Jockkoo/Ohmsprint-2026-4Digitalca/project_files/README.md

# Ohmsprint-2026-4Digitalca
Ohmsprint hackaton 2026. KiCad
