Jockkoo/Ohmsprint-2026-4Digitalca/project_files/Ohmsprint.kicad_pcb

## KiCad design project_files/Ohmsprint.kicad_pcb (2026-04-16)

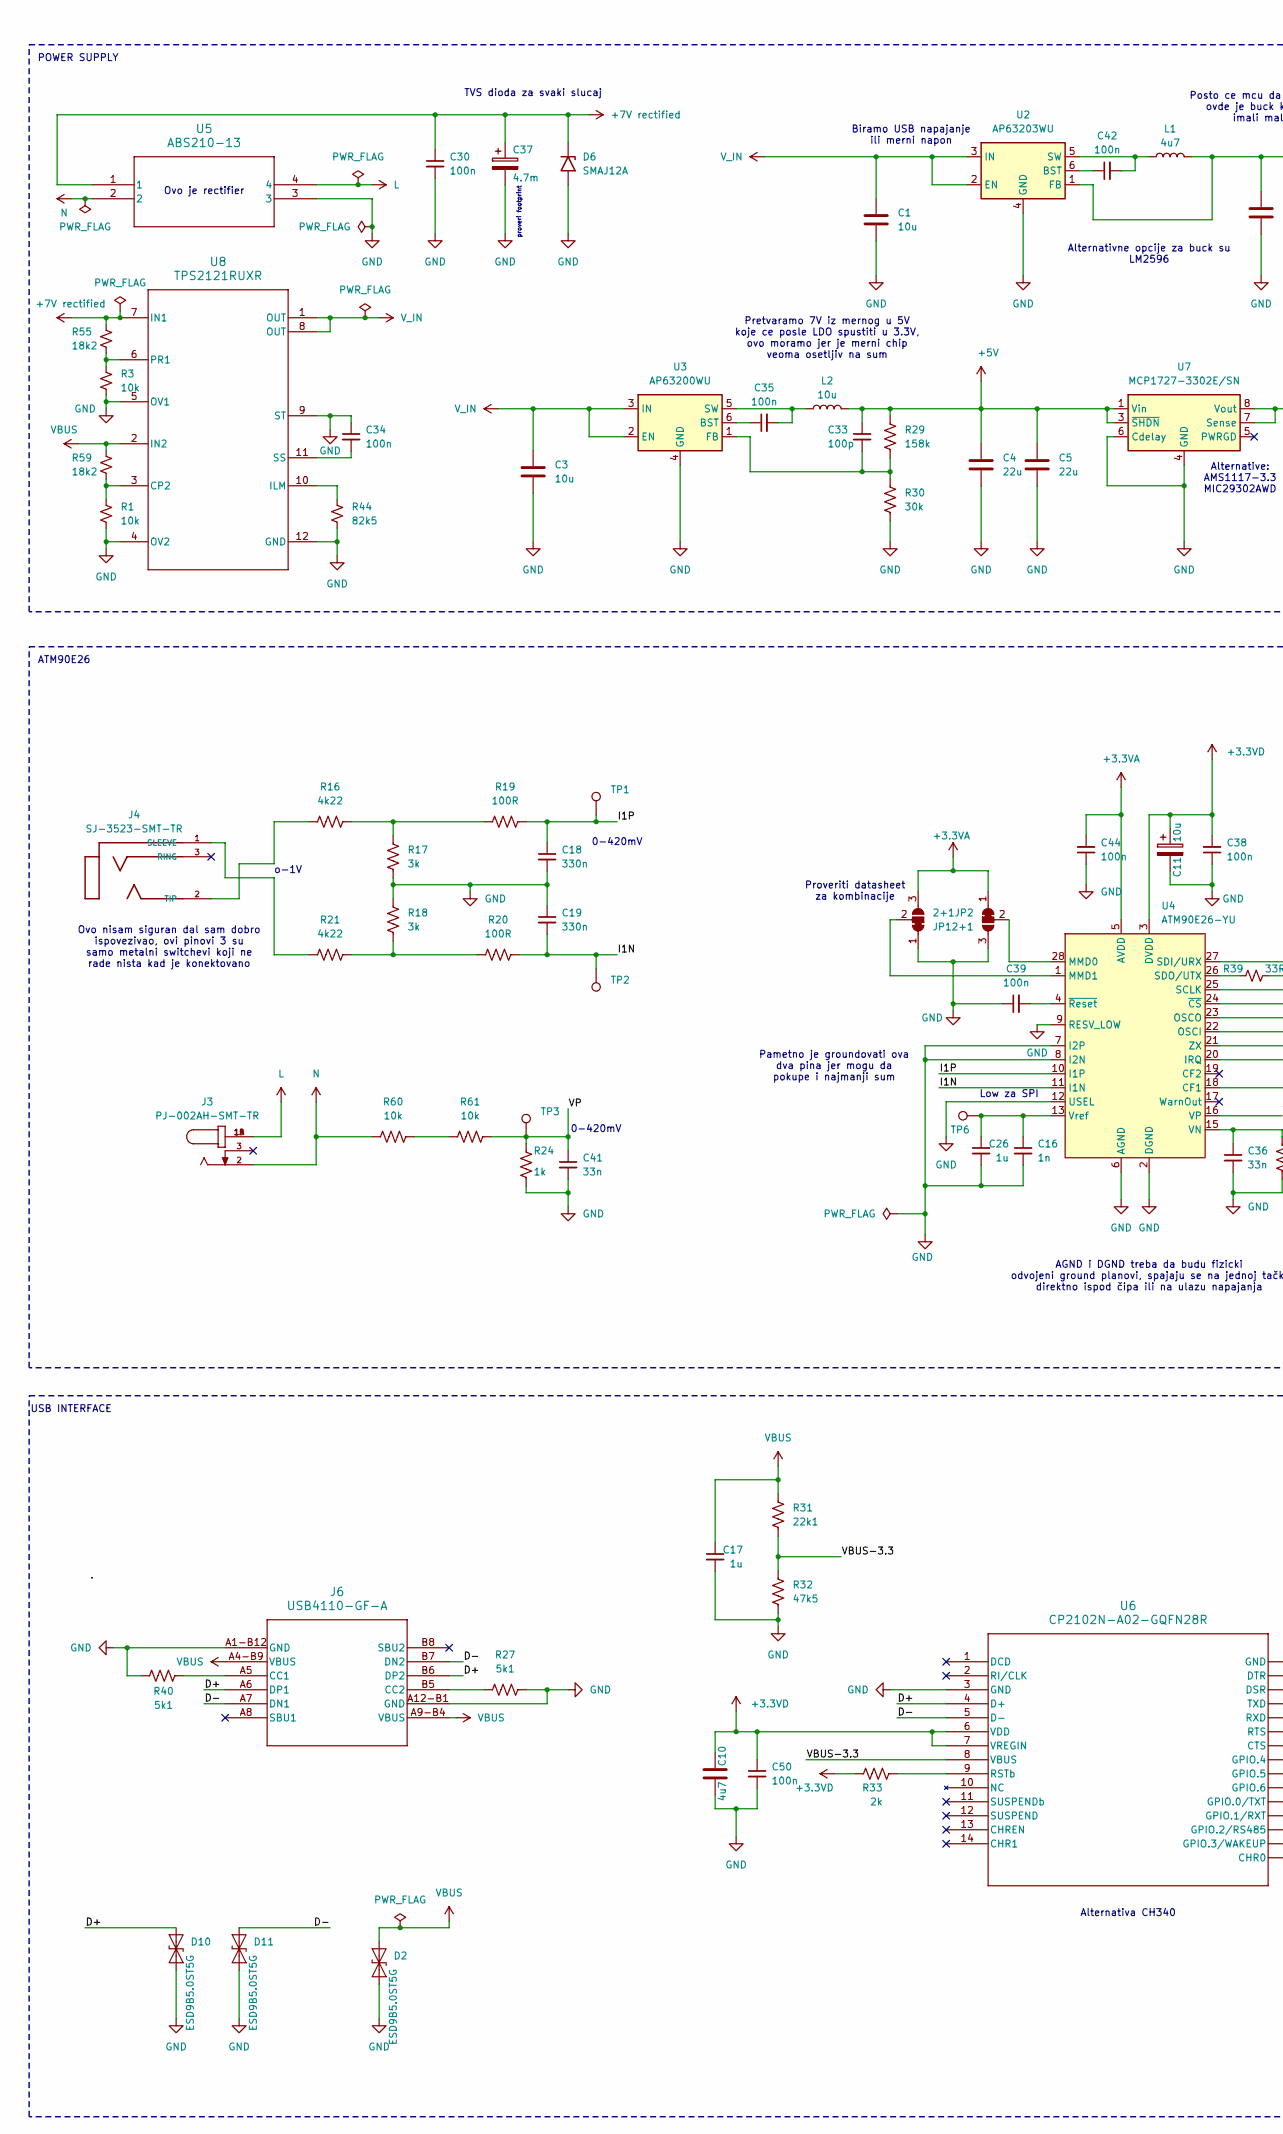
[picture p1: schematic Ohmsprint.kicad_sch, part in row 1, column 1]

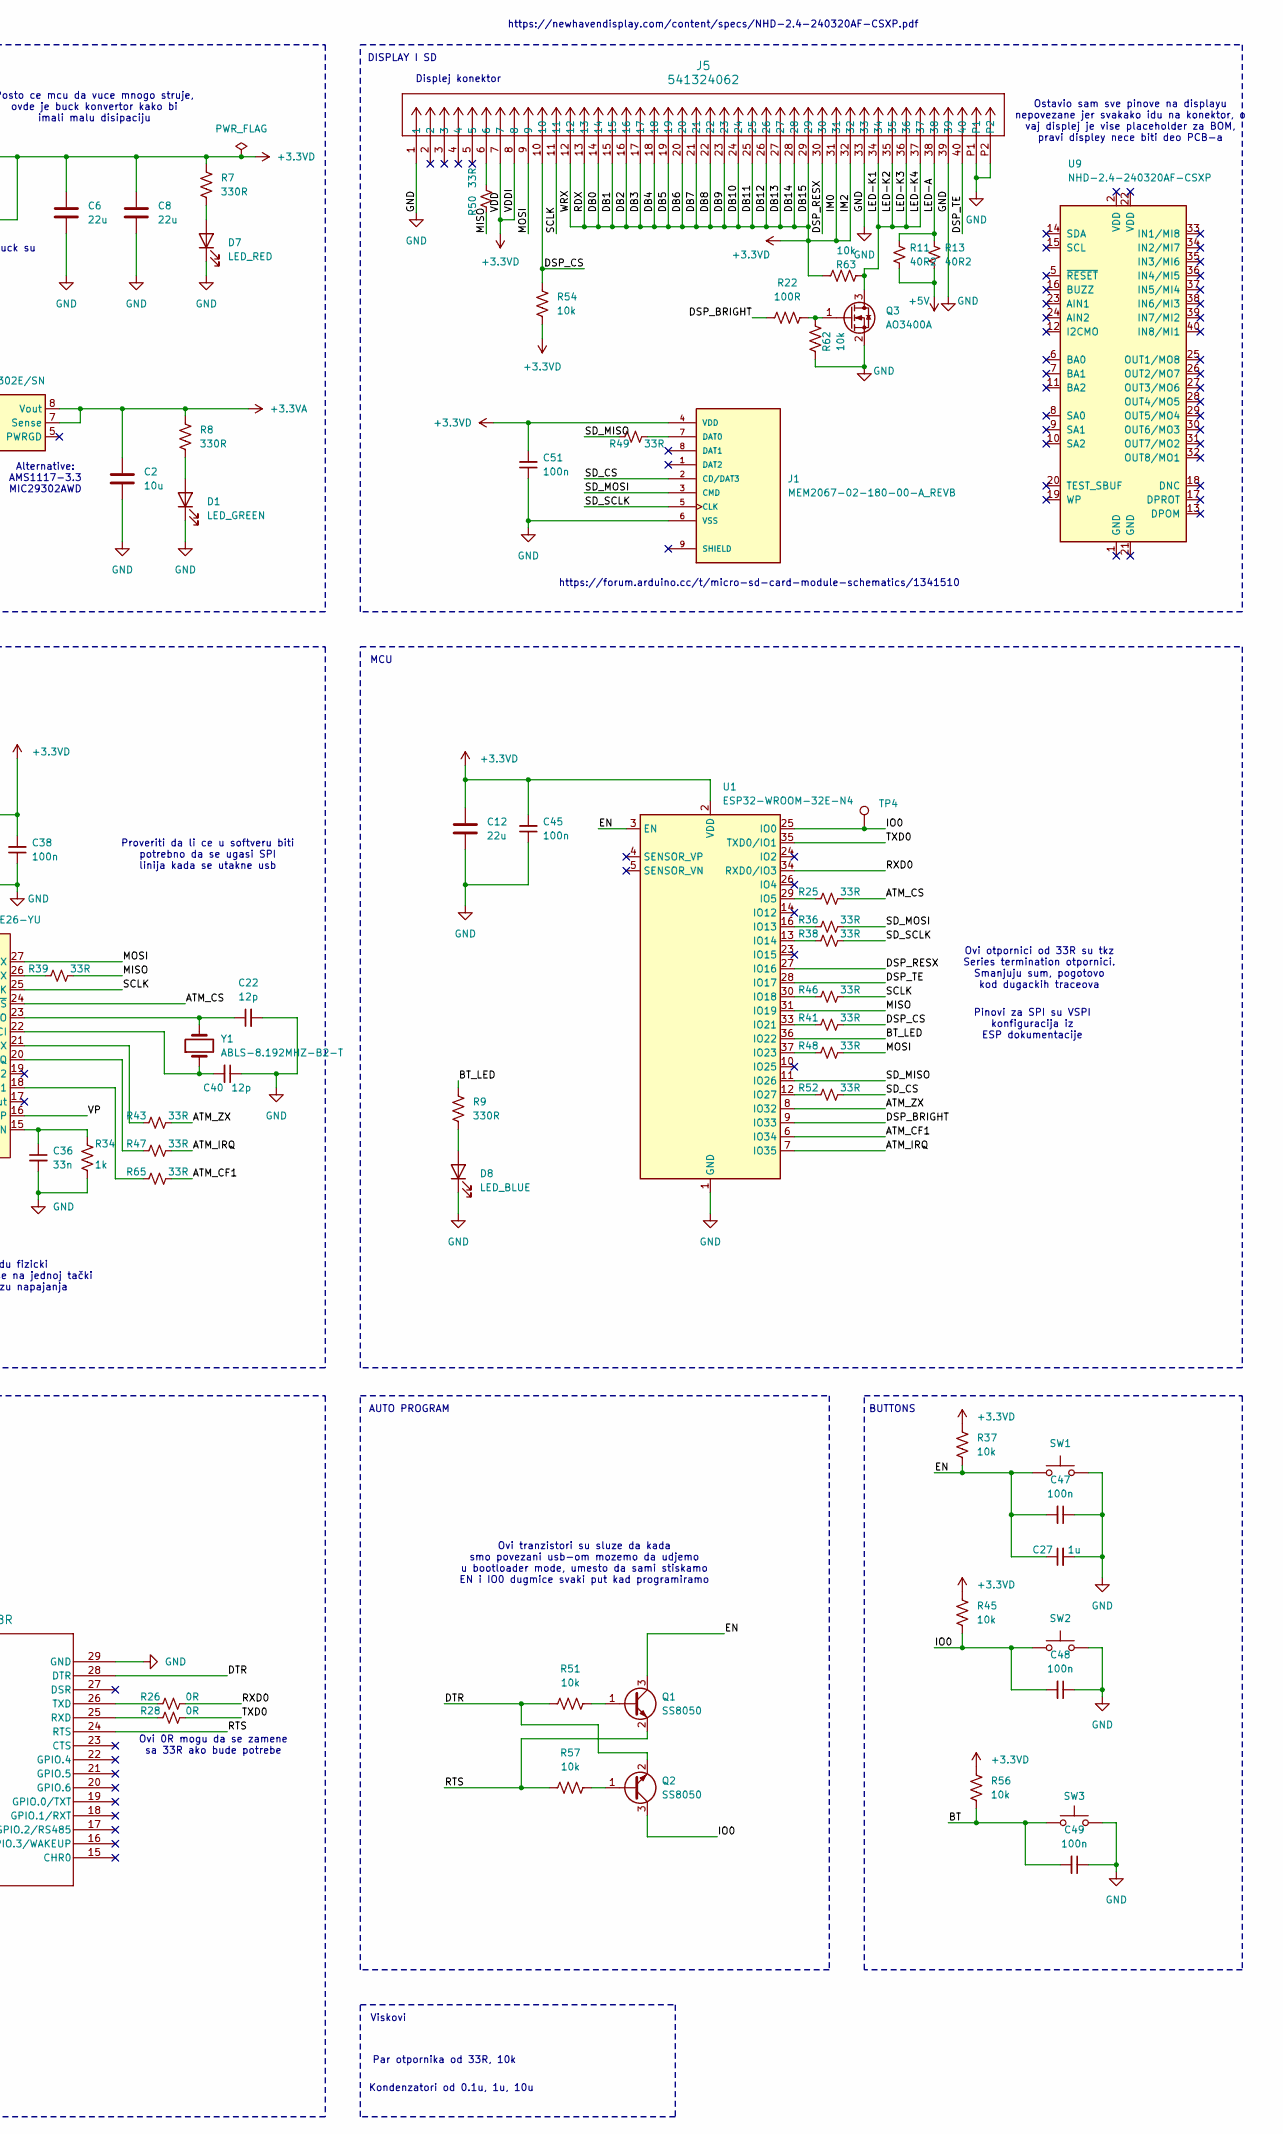
[picture p2: schematic Ohmsprint.kicad_sch, part in row 1, column 2]

Parts:
C1, C2, C3: 10u; C_0805_2012Metric; MPN CL21B106KOQNNNE; DigiKey Part Number 1276-2872-1-ND
C4, C5, C6, C8, C12: 22u; C_1210_3225Metric; MPN CL32B226MOJNNNE; DigiKey Part Number 1276-3395-1-ND
C10: 4u7; C_0603_1608Metric; MPN GRM188R61E475KE11D; DigiKey Part Number 490-7203-1-ND
C11: 10u; CP_Elec_4x5.7; MPN EDH106M016A9BAA; DigiKey Part Number 399-17336-1-ND
C16: 1n; C_0603_1608Metric; MPN C0603C102K5RACTU; DigiKey Part Number 399-C0603C102K5RACTUCT-ND
C17, C26, C27: 1u; C_0603_1608Metric; MPN C0603C105K4RACTU; DigiKey Part Number 399-C0603C105K4RACTUCT-ND
C18, C19: 330n; C_0603_1608Metric; MPN C1608X7R1H334K080AC; DigiKey Part Number 445-5950-1-ND
C22, C40: 12p; C_0603_1608Metric; MPN KGQ15ACG2D120GT; DigiKey Part Number 478-KGQ15ACG2D120GTCT-ND
C30, C34, C35, C38, C39, C42, C44, C45, C47, C48, C49, C50, C51: 100n; C_0603_1608Metric; MPN C0603C104K3RACTU; DigiKey Part Number 399-C0603C104K3RACTUCT-ND
C33: 100p; C_0603_1608Metric; MPN GRM1885C1H101JA01D; DigiKey Part Number 490-1427-1-ND
C36, C41: 33n; C_0603_1608Metric; MPN C0603C333K4RACTU; DigiKey Part Number 399-C0603C333K4RACTUCT-ND
C37: 4.7m; CP_Elec_16x17.5; MPN EMHS160ARA472MLN0S; DigiKey Part Number 565-EMHS160ARA472MLN0SCT-ND
D1: LED_GREEN; LED_0805_2012Metric; MPN LTST-C171KGKT; DigiKey Part Number 160-1426-1-ND
D2, D10, D11: ESD9B5.0ST5G; D_SOD-923; MPN ESD9B5.0ST5G; DigiKey Part Number ESD9B5.0ST5GOSCT-ND
D6: SMAJ12A; D_SMA; MPN SMAJ12A; DigiKey Part Number SMAJ12ALFCT-ND
D7: LED_RED; LED_0805_2012Metric; MPN LTST-C171KRKT; DigiKey Part Number 160-1427-1-ND
D8: LED_BLUE; LED_0805_2012Metric; MPN LTST-C171TBKT; DigiKey Part Number 160-1645-1-ND
J1: MEM2067-02-180-00-A_REVB; GCT_MEM2067-02-180-00-A_REVB; MPN MEM2067-02-180-00-A
J3: PJ-002AH-SMT-TR; CUI_PJ-002AH-SMT-TR; MPN PJ-002AH-SMT-TR; DigiKey Part Number CP-002AHPJCT-ND
J4: SJ-3523-SMT-TR; CUI_SJ-3523-SMT-TR; MPN SJ-3523-SMT-TR; DigiKey Part Number CP-3523SJCT-ND
J5: 541324062; CON_541324062_MOL; MPN 0541324062; DigiKey Part Number WM3436CT-ND
J6: USB4110-GF-A; USB4110-GF-A_GCT; MPN USB4110-GF-A
JP1, JP2: 2+1; SolderJumper-3_P1.3mm_Bridged12_RoundedPad1.0x1.5mm
L1: 4u7; L_1210_3225Metric; MPN 1277AS-H-4R7M=P2; DigiKey Part Number 490-10594-1-ND
L2: 10u; L_1210_3225Metric; MPN AOTA-C322512Q100MT; DigiKey Part Number 535-AOTA-C322512Q100MTCT-ND
Q1, Q2: SS8050; SOT-23; MPN SS8050; DigiKey Part Number 5399-SS8050CT-ND
Q3: AO3400A; SOT-23; MPN AO3400A; DigiKey Part Number 4518-AO3400ACT-ND
R1, R3, R37, R45, R51, R54, R56, R57, R60, R61, R62, R63: 10k; R_0603_1608Metric; MPN RC0603FR-0710KL; DigiKey Part Number 311-10.0KHRCT-ND
R7, R8, R9: 330R; R_0603_1608Metric; MPN RC0603FR-07330RL; DigiKey Part Number 311-330HRCT-ND
R11, R13: 40R2; R_0805_2012Metric; MPN CRCW080540R2FKEA; DigiKey Part Number 541-40.2CCT-ND
R16, R21: 4k22; R_0603_1608Metric; MPN RC0603FR-074K22L; DigiKey Part Number 311-4.22KHRCT-ND
R17, R18: 3k; R_0603_1608Metric; MPN RC0603FR-073KL; DigiKey Part Number 311-3.00KHRCT-ND
R19, R20, R22: 100R; R_0603_1608Metric; MPN RC0603FR-07100RL; DigiKey Part Number 311-100HRCT-ND
R24, R34: 1k; R_0603_1608Metric; MPN RC0603FR-071KL; DigiKey Part Number 311-1.00KHRCT-ND
R25, R36, R38, R39, R41, R43, R46, R47, R48, R49, R50, R52, R65: 33R; R_0603_1608Metric; MPN RC0603FR-0733RL; DigiKey Part Number 13-RC0603FR-0733RLCT-ND
R26, R28: 0R; R_0603_1608Metric; MPN RC0603JR-070RL; DigiKey Part Number 311-0.0GRCT-ND
R27, R40: 5k1; R_0603_1608Metric; MPN RC0603FR-075K1L; DigiKey Part Number 311-5.10KHRCT-ND
R29: 158k; R_0603_1608Metric; MPN RC0603FR-07158KL; DigiKey Part Number 311-158KHRCT-ND
R30: 30k; R_0603_1608Metric; MPN RC0603FR-0730KL; DigiKey Part Number 311-30.0KHRCT-ND
R31: 22k1; R_0603_1608Metric; MPN RC0603FR-0722K1L; DigiKey Part Number 311-22.1KHRCT-ND
R32: 47k5; R_0603_1608Metric; MPN RC0603FR-1047K5L; DigiKey Part Number 13-RC0603FR-1047K5LCT-ND
R33: 2k; R_0603_1608Metric; MPN RC0603FR-072KL; DigiKey Part Number 311-2.00KHRCT-ND
R44: 82k5; R_0805_2012Metric; MPN RMCF0805FT82K5; DigiKey Part Number RMCF0805FT82K5CT-ND
R55, R59: 18k2; R_0603_1608Metric; MPN RC0603FR-0718K2L; DigiKey Part Number 311-18.2KHRCT-ND
SW1, SW2: SW_Push_1_Red; SWITCH_45SK43SMTR92LFS; MPN PTS645SK43SMTR92 LFS; DigiKey Part Number CKN9084CT-ND
SW3: SW_Push_2_Blue; SWITCH_43SMTR92LFS; MPN PTS645SM43SMTR92 LFS; DigiKey Part Number CKN9112CT-ND
TP1, TP2, TP3, TP4, TP6: TestPoint; TestPoint_Pad_D2.0mm
U1: ESP32-WROOM-32E-N4; ESP32-WROOM-32D; MPN ESP32-WROOM-32E-N4; DigiKey Part Number 1965-ESP32-WROOM-32E-N4CT-ND
U2: AP63203WU; TSOT-23-6; MPN AP63203WU-7; DigiKey Part Number AP63203WU-7DICT-ND
U3: AP63200WU; TSOT-23-6; MPN AP63200WU-7; DigiKey Part Number AP63200WU-7DICT-ND
U4: ATM90E26-YU; SSOP-28_5.3x10.2mm_P0.65mm; MPN ATM90E26-YU-R; DigiKey Part Number ATM90E26-YU-RCT-ND
U5: ABS210-13; SON_S210-13_DIO; MPN ABS210-13; DigiKey Part Number ABS210-13DICT-ND
U6: CP2102N-A02-GQFN28R; QFN28_5X5_SIL; MPN CP2102N-A02-GQFN28R; DigiKey Part Number 336-5890-1-ND
U7: MCP1727-3302E/SN; SOIC-8_3.9x4.9mm_P1.27mm; MPN MCP1727T-3302E/SN; DigiKey Part Number MCP1727T-3302E/SNCT-ND
U8: TPS2121RUXR; RUX0012A; MPN TPS2121RUXR; DigiKey Part Number 296-53410-1-ND
U9: NHD-2.4-240320AF-CSXP; EA_eDIPTFT32-XXX; MPN NHD-2.4-240320AF-CSXP; DigiKey Part Number 757-NHD-2.4-240320AF-CSXP-ND
Y1: ABLS-8.192MHZ-B2-T; Crystal_SMD_HC49-SD; MPN ABLS-8.192MHZ-B2-T; DigiKey Part Number 535-9090-1-ND

Connections:
+3.3VA: C2.1, C44.2, JP1.3 (B), JP2.1 (A), R8.1, U4.5 (AVDD), U7.7 (Sense), U7.8 (Vout)
+3.3VD: C6.1, C8.1, C10.1, C11.1, C12.1, C38.2, C45.2, C50.1, C51.2, J1.4 (VDD), J5.7, J5.8, J5.12, J5.13, J5.14, J5.15, J5.16, J5.17, J5.18, J5.19, J5.20, J5.21, J5.22, J5.23, J5.24, J5.25, J5.26, J5.27, J5.28, J5.29, J5.31, J5.32, L1.2, R7.1, R33.1, R37.2, R45.2, R54.1, R56.2, R63.1, U1.2 (VDD), U2.1 (FB), U4.3 (DVDD), U6.6 (VDD), U6.7 (VREGIN); also elsewhere on the board
+5V: C4.1, C5.1, C33.1, L2.2, R11.2, R13.2, R29.1, U7.1 (Vin), U7.2 (Vin), U7.3 (~SHDN)
+7V rectified: C30.1, C37.1, D6.1 (A1), R55.1, U5.1, U8.7 (IN1)
/ATM_CF1: R65.2, U1.6 (IO34)
/ATM_CS: R25.2, U4.24 (~CS)
/ATM_IRQ: R47.2, U1.7 (IO35)
/ATM_ZX: R43.2, U1.8 (IO32)
/BT: C49.2, R56.1, SW3.1
/BT_LED: R9.1, U1.36 (IO22)
/D+: D10.2 (A2), J6.A6 (DP1), J6.B6 (DP2), U6.4 (D+)
/D-: D11.2 (A2), J6.A7 (DN1), J6.B7 (DN2), U6.5 (D-)
/DSP_BRIGHT: R22.1, U1.9 (IO33)
/DSP_CS: J5.10, R41.2, R54.2
/DSP_RESX: J5.30, U1.27 (IO16)
/DSP_TE: J5.40, U1.28 (IO17)
/DTR: Q2.2 (E), R51.2, U6.28 (DTR)
/EN: C27.1, C47.2, Q1.3 (C), R37.1, SW1.1, U1.3 (EN)
/I1N: C19.2, R20.2, TP2.1 (1_1), U4.11 (I1N)
/I1P: C18.1, R19.2, TP1.1 (1_1), U4.10 (I1P)
/IO0: C48.2, Q2.3 (C), R45.1, SW2.1, TP4.1 (1_1), U1.25 (IO0)
/LED-A: J5.38, R11.1, R13.1
/LED-K1: J5.34, J5.35, J5.36, J5.37, Q3.3 (D), R63.2
/MISO: R39.2, R50.1, U1.31 (IO19)
/MOSI: J5.9, R48.2, U4.27 (SDI/URX)
/RTS: Q1.2 (E), R57.2, U6.24 (RTS)
/RXD0: R26.2, U1.34 (RXD0/IO3)
/SCLK: J5.11, R46.2, U4.25 (SCLK)
/SD_CS: J1.2 (CD/DAT3), R52.2; also elsewhere on the board
/SD_MISO: R49.1, U1.11 (IO26)
/SD_MOSI: J1.3 (CMD), R36.2
/SD_SCLK: J1.5 (CLK), R38.2
/TXD0: R28.2, U1.35 (TXD0/IO1)
/VBUS-3.3: R31.2, R32.1, U6.8 (VBUS)
/VP: C41.1, R24.2, R61.1, TP3.1 (1_1), U4.16 (VP)
GND: C1.2, C2.2, C3.2, C4.2, C5.2, C6.2, C8.2, C10.2, C11.2, C12.2, C16.2, C17.2, C18.2, C19.1, C22.2, C26.2, C27.2, C30.2, C34.1, C36.2, C37.2, C38.1, C39.1, C40.1, C41.2, C44.1, C45.1, C47.1, C48.1, C49.1, C50.2, C51.1, D1.1 (K), D2.1 (A1), D6.2 (A2), D7.1 (K), D8.1 (K), D10.1 (A1), D11.1 (A1), J1.6 (VSS), J5.1, J5.33, J5.39, J5.P1, J5.P2, J6.A1-B12 (GND), J6.A12-B1 (GND), JP1.1 (A), JP2.3 (B), Q3.2 (S), R1.2, R3.2, R17.2, R18.1, R24.1, R27.2, R30.2, R32.2, R34.1, R40.1, R44.2, R62.2, SW1.2, SW2.2, SW3.2, U1.1 (GND), U1.15 (GND), U1.38 (GND), U1.39 (GND), U2.4 (GND), U3.4 (GND), U4. (RESV_LOW), U4.2 (DGND), U4.6 (AGND), U4.7 (I2P), U4.8 (I2N), U4.9 (DGND), U4.12 (USEL), U4.14 (AGND), U5.3, U6.3 (GND), U6.29 (GND), U7.4 (GND), U7.6 (Cdelay), U8.4 (OV2), U8.5 (OV1), U8.9 (ST), U8.12 (GND)
L: J3.1A, J3.1B, U5.4
N: J3.2, R60.2, U5.2
unnamed: D1.2 (A), R8.2
unnamed: D7.2 (A), R7.2
unnamed: D8.2 (A), R9.2
unnamed: J1.7 (DAT0), R49.2
unnamed: J4.1 (SLEEVE), R21.1
unnamed: J4.2 (TIP), R16.1
unnamed: J5.6, R50.2
unnamed: J6.A5 (CC1), R40.2
unnamed: J6.B5 (CC2), R27.1
unnamed: JP1.2 (C), U4.1 (MMD1)
unnamed: JP2.2 (C), U4.28 (MMD0)
unnamed: Q1.1 (B), R51.1
unnamed: Q2.1 (B), R57.1
unnamed: Q3.1 (G), R22.2, R62.1
unnamed: R16.2, R17.1, R19.1
unnamed: R18.2, R20.1, R21.2
unnamed: R60.1, R61.2
unnamed: R25.1, U1.29 (IO5)
unnamed: R36.1, U1.16 (IO13)
unnamed: R38.1, U1.13 (IO14)
unnamed: R46.1, U1.30 (IO18)
unnamed: R41.1, U1.33 (IO21)
unnamed: R48.1, U1.37 (IO23)
unnamed: R52.1, U1.12 (IO27)
unnamed: C42.1, U2.6 (BST)
unnamed: C42.2, L1.1, U2.5 (SW)
unnamed: C35.1, U3.6 (BST)
unnamed: C33.2, R29.2, R30.1, U3.1 (FB)
unnamed: C35.2, L2.1, U3.5 (SW)
unnamed: R65.1, U4.18 (CF1)
unnamed: R47.1, U4.20 (IRQ)
unnamed: C40.2, U4.22 (OSCI), Y1.1
unnamed: C22.1, U4.23 (OSCO), Y1.2
unnamed: R39.1, U4.26 (SDO/UTX)
unnamed: C36.1, R34.2, U4.15 (VN)
unnamed: C16.1, C26.1, TP6.1 (1_1), U4.13 (Vref)
unnamed: R43.1, U4.21 (ZX)
unnamed: C39.2, U4.4 (~Reset)
unnamed: R33.2, U6.9 (RSTb)
unnamed: R28.1, U6.25 (RXD)
unnamed: R26.1, U6.26 (TXD)
unnamed: R1.1, R59.2, U8.3 (CP2)
unnamed: R44.1, U8.10 (ILM)
unnamed: R3.1, R55.2, U8.6 (PR1)
unnamed: C34.2, U8.11 (SS)
VBUS: C17.1, D2.2 (A2), J6.A4-B9 (VBUS), J6.A9-B4 (VBUS), R31.1, R59.1, U8.2 (IN2)
V_IN: C1.1, C3.1, U2.2 (EN), U2.3 (IN), U3.2 (EN), U3.3 (IN), U8.1 (OUT), U8.8 (OUT)

Notes on the sheet:
o-1V
TVS dioda za svaki slucaj
0-420mV
AUTO PROGRAM
BUTTONS
Par otpornika od 33R, 10k
MCU
Alternative: AMS1117-3.3 MIC29302AWD
https://forum.arduino.cc/t/micro-sd-card-module-schematics/1341510
POWER SUPPLY
Ostavio sam sve pinove na displayu nepovezane jer svakako idu na konektor, o vaj displej je vise placeholder za BOM, pravi displey nece biti deo PCB-a
Biramo USB napajanje ili merni napon
Kondenzatori od 0.1u, 1u, 10u
Posto ce mcu da vuce mnogo struje, ovde je buck konvertor kako bi imali malu disipaciju
Alternativa CH340
Proveriti da li ce u softveru biti potrebno da se ugasi SPI linija kada se utakne usb
Ovi otpornici od 33R su tkz Series termination otpornici. Smanjuju sum, pogotovo kod dugackih traceova
https://newhavendisplay.com/content/specs/NHD-2.4-240320AF-CSXP.pdf
Displej konektor
Pinovi za SPI su VSPI konfiguracija iz ESP dokumentacije
proveri footprint
Alternativne opcije za buck su LM2596
Ovi 0R mogu da se zamene sa 33R ako bude potrebe
Pametno je groundovati ova dva pina jer mogu da pokupe i najmanji sum
Ovo je rectifier
Pretvaramo 7V iz mernog u 5V koje ce posle LDO spustiti u 3.3V, ovo moramo jer je merni chip veoma osetljiv na sum
AGND i DGND treba da budu fizicki odvojeni ground planovi, spajaju se na jednoj tački direktno ispod čipa ili na ulazu napajanja
Ovo nisam siguran dal sam dobro ispovezivao, ovi pinovi 3 su samo metalni switchevi koji ne rade nista kad je konektovano
Viskovi
Low za SPI
Proveriti datasheet za kombinacije
DISPLAY I SD
USB INTERFACE
Ovi tranzistori su sluze da kada smo povezani usb-om mozemo da udjemo u bootloader mode, umesto da sami stiskamo EN i IO0 dugmice svaki put kad programiramo
ATM90E26

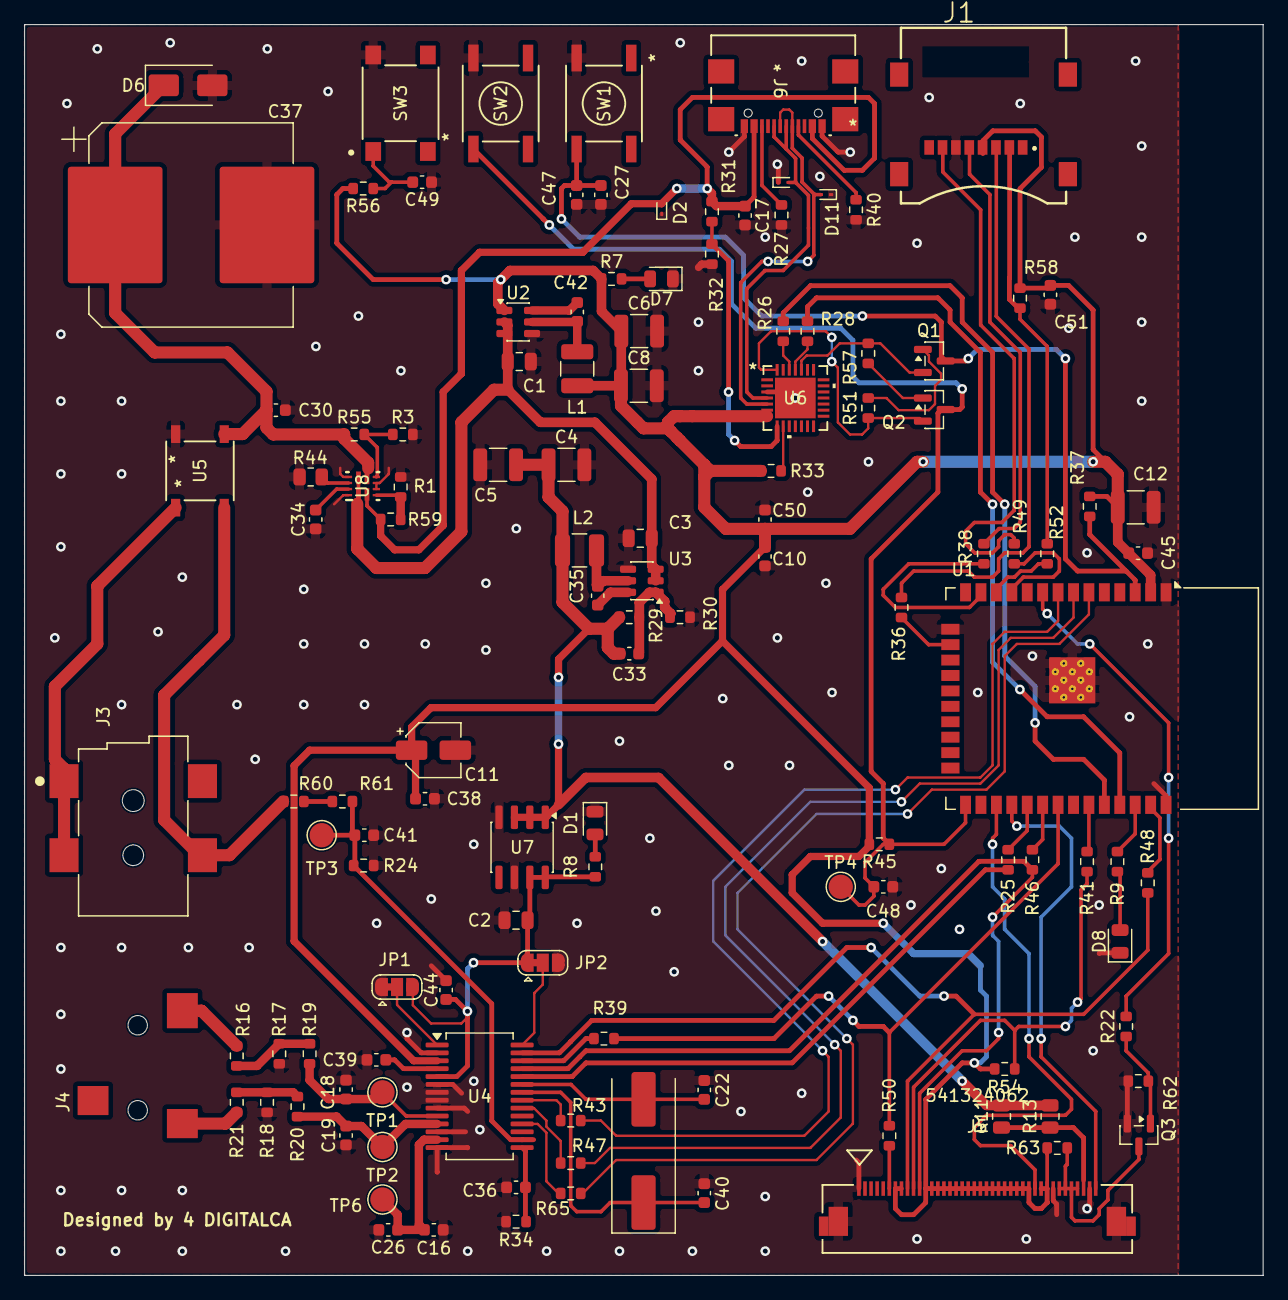
[picture p3: board Ohmsprint.kicad_pcb from above]

Board: 2 copper layers, 102.0 x 103.0 mm, 123 parts (0 on the bottom side), 85 nets.

Other parts of the board:
R58: 10k; R_0603_1608Metric

Their connections:
+3.3VD: R58.2; also elsewhere on the board
/SD_CS: R58.1; also elsewhere on the board
