Jockkoo/Ohmsprint-2026-4Digitalca/(commit log)

2026-04-07 Dodati connectori i rectifier
    [Ohmsprint.kicad_pcb, Ohmsprint.kicad_sch]
2026-04-08 Buck konvertor, jumperi, SPI, DigiKey proizvodi
    [Ohmsprint.kicad_sch]
2026-04-09 Novi power supply, doradjena sema
    [Ohmsprint.kicad_sch]
2026-04-11 Displej, SD kartica, DigiKey modeli
    [Ohmsprint.kicad_sch]
2026-04-12 Power MUX, Display, Part numbers, Manufacturers and Footprints
    [Ohmsprint.kicad_sch]
2026-04-12 Displej napajanje reseno (valjda)
    [Ohmsprint.kicad_sch]
2026-04-12 Generisan Bill of Materials
    [BOM_ver1.csv, Ohmsprint.kicad_sch]
2026-04-13 Update PCB layout-a
    [Ohmsprint.kicad_pcb]
2026-04-15 USB :)
    [BOM_ver1.csv, Ohmsprint.kicad_pcb, Ohmsprint.kicad_sch]
2026-04-15 Uradjeno pola rutiranja
    [Ohmsprint.kicad_pcb, Ohmsprint.kicad_sch]
2026-04-16 Uradjen PCB
    [Ohmsprint.kicad_pcb, Ohmsprint.kicad_sch]
2026-04-16 Generisani Gerber i Drill
    [Ohmsprint-B_Courtyard.gbr, Ohmsprint-B_Cu.gbr, Ohmsprint-B_Mask.gbr, Ohmsprint-B_Paste.gbr, Ohmsprint-B_Silkscreen.gbr, Ohmsprint-Edge_Cuts.gbr, Ohmsprint-F_Courtyard.gbr, Ohmsprint-F_Cu.gbr]
